ginos1998/SDC-TP_Final/DOCUMENTACION/Proyecto-Integrador-Informe-V1.1.0.docx.pdf

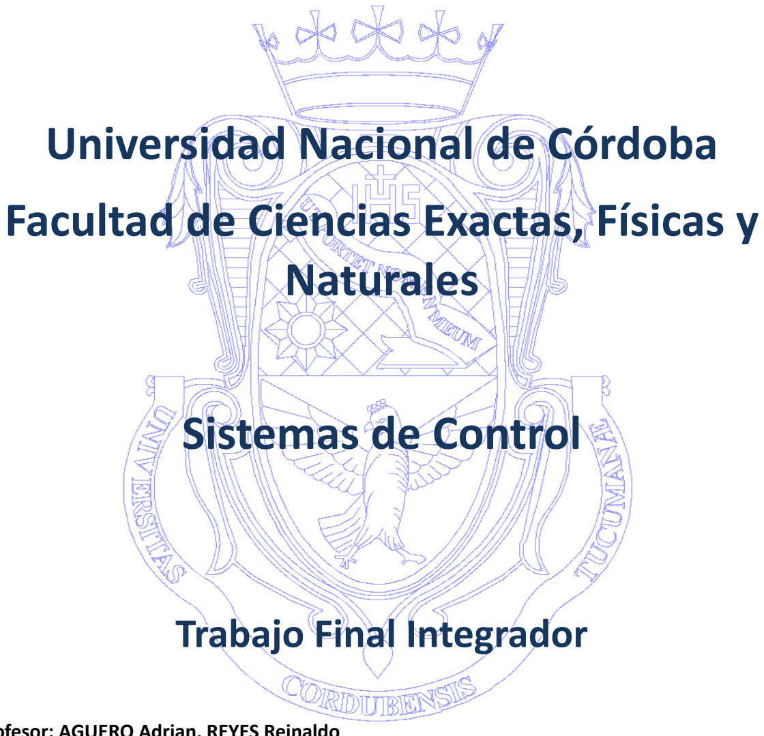
[picture p1: figure]
Universidad Nacional de Córdoba; Facultad de Ciencias Exactas, Físicas y Naturales; Sistemas de Control; Trabajo Final Integrador

Profesor: AGUERO Adrian, REYES Reinaldo

Alumno/s: SIAMPICHETTI Gino, MAFFINI Agustin

Matrícula/s: 41411540,

Carrera: Ing Computación

UNC- FCEFyN | Sistemas de Control

# Índice

Introducción | 2
Análisis sin considerar la carga | 3
Determinación de los elementos a utilizar | 3
Modelado del motor de corriente continua | 3
Diagrama de bloques del sistema | 5
Determinación de la función de transferencia del sistema | 5
Estimación 1 | 6
Estimación 2 | 8
Análisis del error de régimen permanente | 10
Respuesta transitoria | 11
Análisis de Estabilidad | 12
Lugar de Raíces | 13
Análisis considerando la carga | 14
Diagrama de bloques del sistema completo | 14
Determinación de la función de transferencia del sistema completo | 15
Compensación | 16
Ajuste del Compensador | 19
Respuesta del sistema compensado para una entrada escalón | 22
Lugar de Raíces | 23
Análisis del error de régimen permanente | 24
Análisis de estabilidad de Routh-Hurwitz | 24
Diagrama de Bode del sistem | 25
Esquema del circuito físico | 25
Conclusión | 26
ANEXO | 27
Obtención de datos para calcular la función de transferencia de la planta | 27
Implementación de PID en Arduino | 28
Filtro de Media Móvil Exponencial | 28

## Introducción

Con el fin de aplicar los conocimientos adquiridos en la asignatura Sistemas de Control I, desarrollamos este trabajo práctico integrador basándonos en el control de levitación de una pelota de telgopor, la cual se desplaza verticalmente dentro de un tubo cilíndrico transparente, impulsada por un soplador de aire (motor CD con paletas planas perpendiculares al sentido de giro). La posición de la pelota es ajustada con la posición de la mano, detectada por un sensor ultrasónico, con un rango de 0-39 cm.

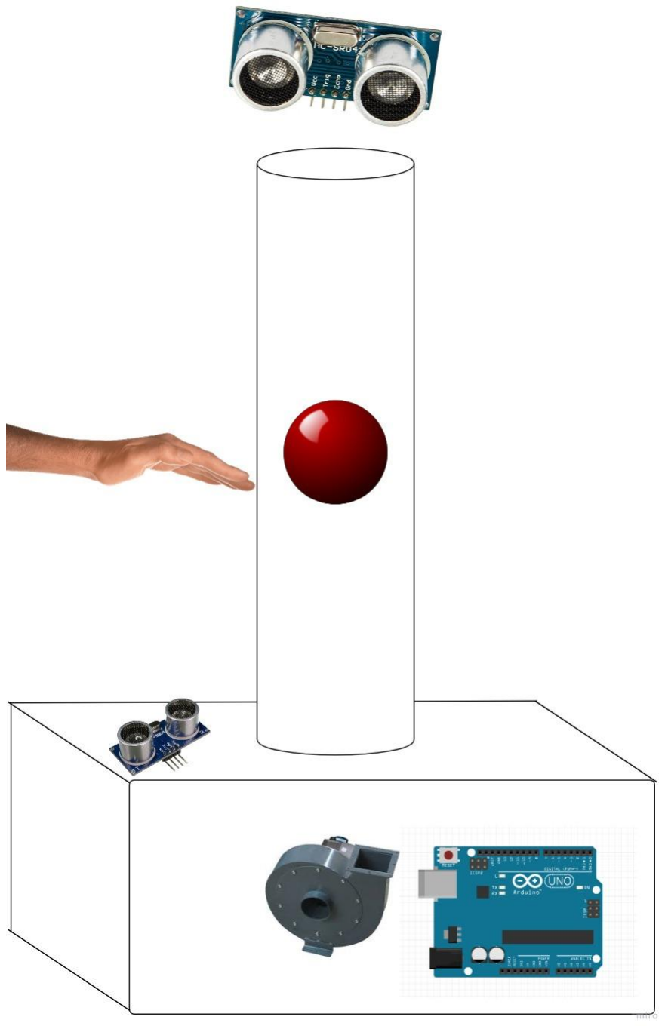
[picture p2: figure]

## Desarrollo

## Análisis sin considerar la carga

### Determinación de los elementos a utilizar

- Arduino UNO
- Motor DC (Datasheet) (https://github.com/ginos1998/SDC-TP_Final/blob/master/DOCUMENTACION/RF-370CA-153.pdf)
- (2) Sensor ultrasonico HC-SR04 (Datasheet) (https://github.com/ginos1998/SDC-TP_Final/blob/master/DOCUMENTACION/Datasheet-HC-SR04.pdf)
- Resistencia 220 [Ω]
- Transistor NPN 2N2222A
- Diodo 1N4007
- Esfera telgopor (pelota)
- Protoboard
- Entre otros

### Modelado del motor de corriente continua

El motor DC controlado por inducido utiliza la corriente del inducido como la variable de control. El campo en el estator se puede establecer mediante una bobina de excitación y corriente o un imán permanente. En la siguiente figura se muestran los elementos más importantes:

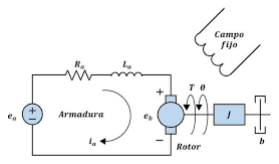
[picture p3: figure]

Podemos analizar este circuito en el dominio del tiempo, planteando las siguientes ecuaciones

e
a

(t) = R
a

i
a

(t) + L
a

di
a

(t)
dt + e
b

(t)

e
a

(t) − R
a

i
a

(t) − e
b

(t) = L
a

di
a

(t)
dt

(1)

donde e es la fuerza contraelectromotriz.
b

(t)

Observando la parte mecánica,

T
m

(t) = J

dω(t)
dt + Bω(t)

T
m

(t) − Bω(t) = J

dω(t)
dt

(2)

Donde T | es el torque del motor de corriente continua, es el coeficiente de fricción equivalente al m
(t) | B
motor de CD (corriente continua) y la carga montados sobre el eje del motor, J es el momento de inercia total del rotor y de la carga con relación al eje del motor, ω(t) es la velocidad angular del motor y

dω(t)
dt
es la aceleración angular.

Asumiendo que existe una relación proporcional K (constante contraelectromotriz ) entre el voltaje
a

V
rad s
inducido en la armadura y la velocidad angular del eje del motor,

e
b

(t) = Kaω(t) (3)

Y se supone la siguiente relación electromecánica que establece que el torque mecánico es proporcional, K (Constante de Torque [Nm / A]), a la corriente eléctrica que circula por el motor DC. m

T
m

(t) = Km

i
a

(t) (4)

Podemos aplicar la transformada de Laplace a las ecuaciones 1, 2, 3 y 4 para obtener con mayor facilidad la función de transferencia

E
a

(s) − R
a

I
a

(s) − E
b

(s) = sL
a

I
a

(s) (5)

T
m

(s) − Bω(s) = Jsω(s) (6)

E
b

(s) = Kaω(s) (7)

T
m

(s) = Km

I
a

(s) (8)

Queremos obtener la relación velocidad angular con el voltaje de entrada, ω(s)/E .
a

(s)

De la ecuación 8, podemos despejar la corriente

I
a

(s) =

T
m

(s)
Km

(9)

de la ecuación 6, despejamos el torque del motor

T
m

(s) = ω(s)(Js + B) (10)

reemplazamos la ecuación 10 en la 9

I | )
a

(s) =

ω(s)(Js+B)
Km

(11

reemplazamos la ecuación 7 en la 5 y agrupamos los términos en función de la corriente

E
a

(s) − Kaω(s) = I
a

(s)(sL

a + R
a

) (12)

reemplazamos la ecuación 11 en la 12 y agrupamos los términos en función de la velocidad angular

E
a

(s) − Kaω(s) =

ω(s)(Js+B)
Km

(sL

a + R
a

)

E
a

(s) = ω(s)[

(Js+B)(sL

a+R
a

)
Km

+ Ka

]

E
a

(s) = ω(s)[

(Js+B)(sL

a+R
a

)+Ka

Km
Km

]

por último, despejamos y desarrollamos para obtener la relación entre el voltaje de entrada y la velocidad (salida):

ω(s)
E
a

(s) =

Km
(Js+B)(sL

a+R
a

)+Ka

Km

ω(s)
E
a

(s) =

Km

JL
a

s

2+(JR
a+BL
a

)s+Ka

Km

### Diagrama de bloques del sistema

Respecto al modelado matemático, el diagrama de bloques en el dominio de Laplace es

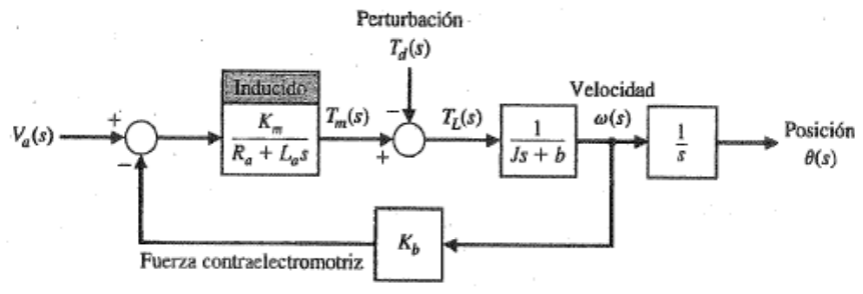
[picture p4: figure]

Si bien el motor CD es de lazo abierto, la realimentación negativa de ganancia K se ilustra solo para el
b
modelo matemático.

### Determinación de la función de transferencia del sistema

Para determinar la función de transferencia a lazo abierto del motor de corriente continua utilizado, al desconocer sus características físicas, optamos por realizar mediciones experimentales con ayuda del Arduino UNO, un módulo de sensor infrarrojo y en el eje del motor colocamos una hélice liviana de 8 palas. De esta manera, al girar la hélice, el sensor infrarrojo detecta las palas y el Arduino cuenta la cantidad en un tiempo de muestreo determinado, mediante interrupciones. El resultado es RAD/s ante la entrada escalón unitario sobre el motor CD. Ver código implementado en Arduino. (https://github.com/ginos1998/SDC-TP_Final/blob/master/ARDUINO/measure-rpm/measure-rpm.ino)

A continuación, se detalla el procedimiento introducido en Matlab para obtener la función de transferencia a partir de los resultados obtenidos. (https://docs.google.com/spreadsheets/d/1CccnxNx0YsGrc_fS6bcSLwauPOYd9gacbLGMbrZcVQQ/edit?usp=sharing)

Estimación 1

Se definieron los vectores u y rads (entrada escalón y velocidad angular, respectivamente). La herramienta 'iddata()' nos permite encapsular los valores medidos de entrada y salida para el sistema (motor) que queremos identificar, con un tiempo de muestreo dado. (Datos: hoja 1) (https://docs.google.com/spreadsheets/d/1CccnxNx0YsGrc_fS6bcSLwauPOYd9gacbLGMbrZcVQQ/edit#gid=0)

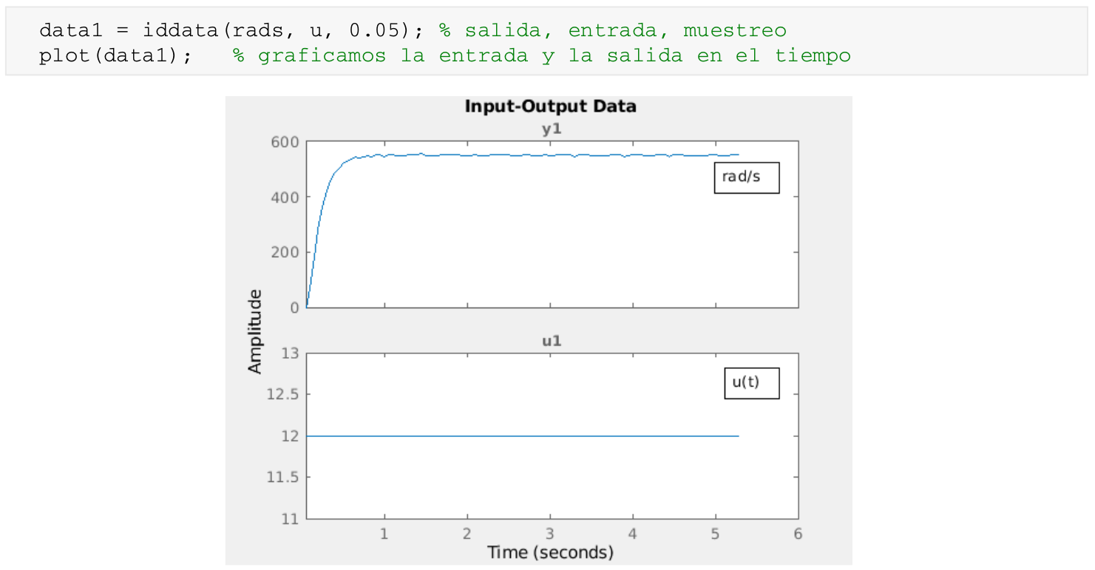
[picture p5: figure]

Con la herramienta 'tfest()' realizamos una estimación de la función de transferencia, según los polos y ceros que indiquemos. En principio, el sistema parece ser de primer orden:

obteniendo una estimación muy buena del 90.9%. Sin embargo, del modelado matemático sabemos que la función de transferencia de un motor CD es de segundo orden, con 2 polos y ningún zero:

En este caso, la estimación aumentó a 97.65% y la función de transferencia calculada es

TF
20

(s) =

8104
s

2+31.83s+176.6

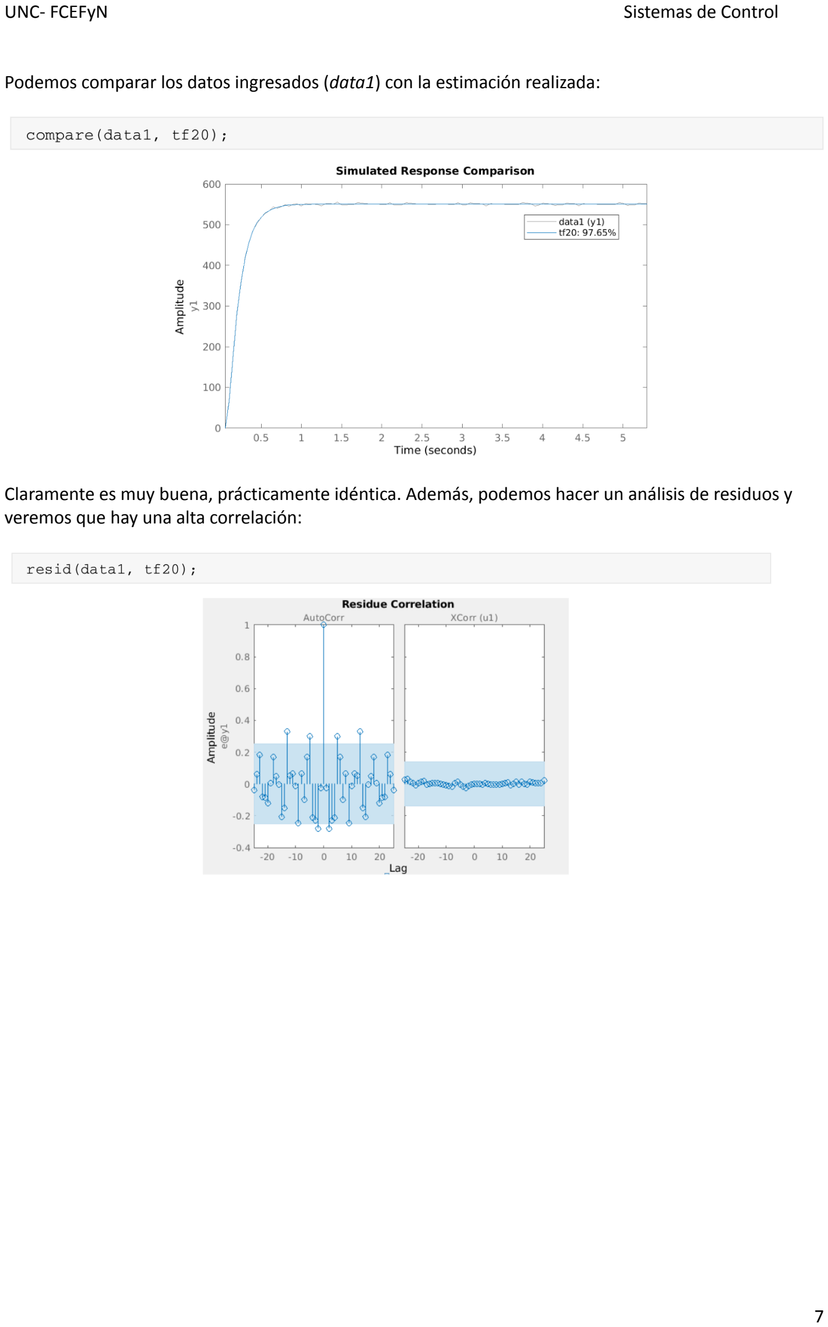
[picture p6: page 8]

Podemos comparar los datos ingresados (data1) con la estimación realizada:

Claramente es muy buena, prácticamente idéntica. Además, podemos hacer un análisis de residuos y veremos que hay una alta correlación:

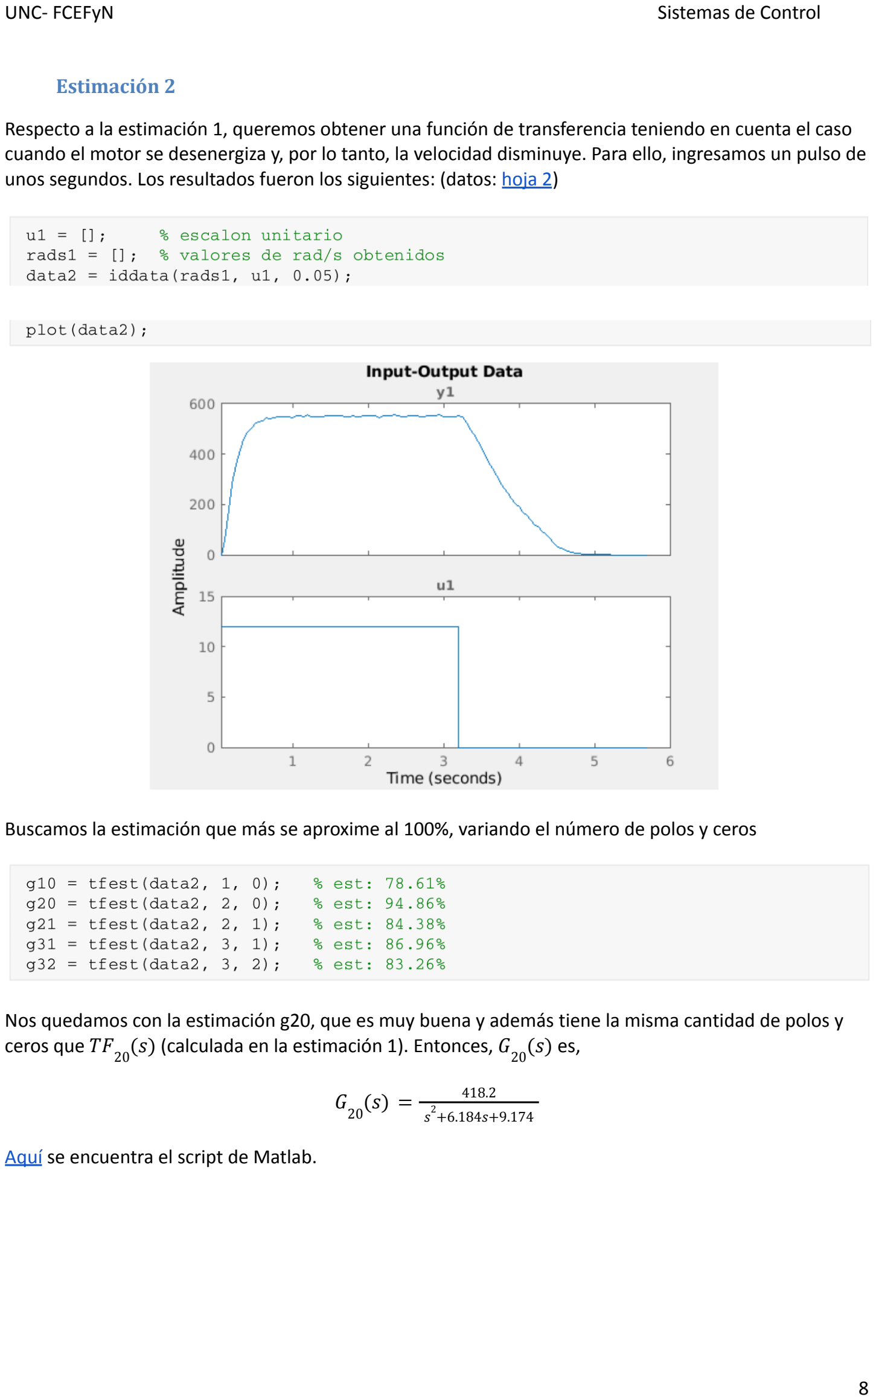
[picture p7: page 9]

Estimación 2

Respecto a la estimación 1, queremos obtener una función de transferencia teniendo en cuenta el caso cuando el motor se desenergiza y, por lo tanto, la velocidad disminuye. Para ello, ingresamos un pulso de unos segundos. Los resultados fueron los siguientes: (datos: hoja 2) (https://docs.google.com/spreadsheets/d/1CccnxNx0YsGrc_fS6bcSLwauPOYd9gacbLGMbrZcVQQ/edit)

Buscamos la estimación que más se aproxime al 100%, variando el número de polos y ceros

Nos quedamos con la estimación g20, que es muy buena y además tiene la misma cantidad de polos y
ceros que TF | (calculada en la estimación 1). Entonces, | es,
20
(s) | G
20

(s)

| G
| 20 (s) =
| 418.2 s 2+6.184s+9.174

Aquí (https://github.com/ginos1998/SDC-TP_Final/blob/master/SCRIPTS-MATLAB/estimaciones_tf.mlx) se encuentra el script de Matlab.

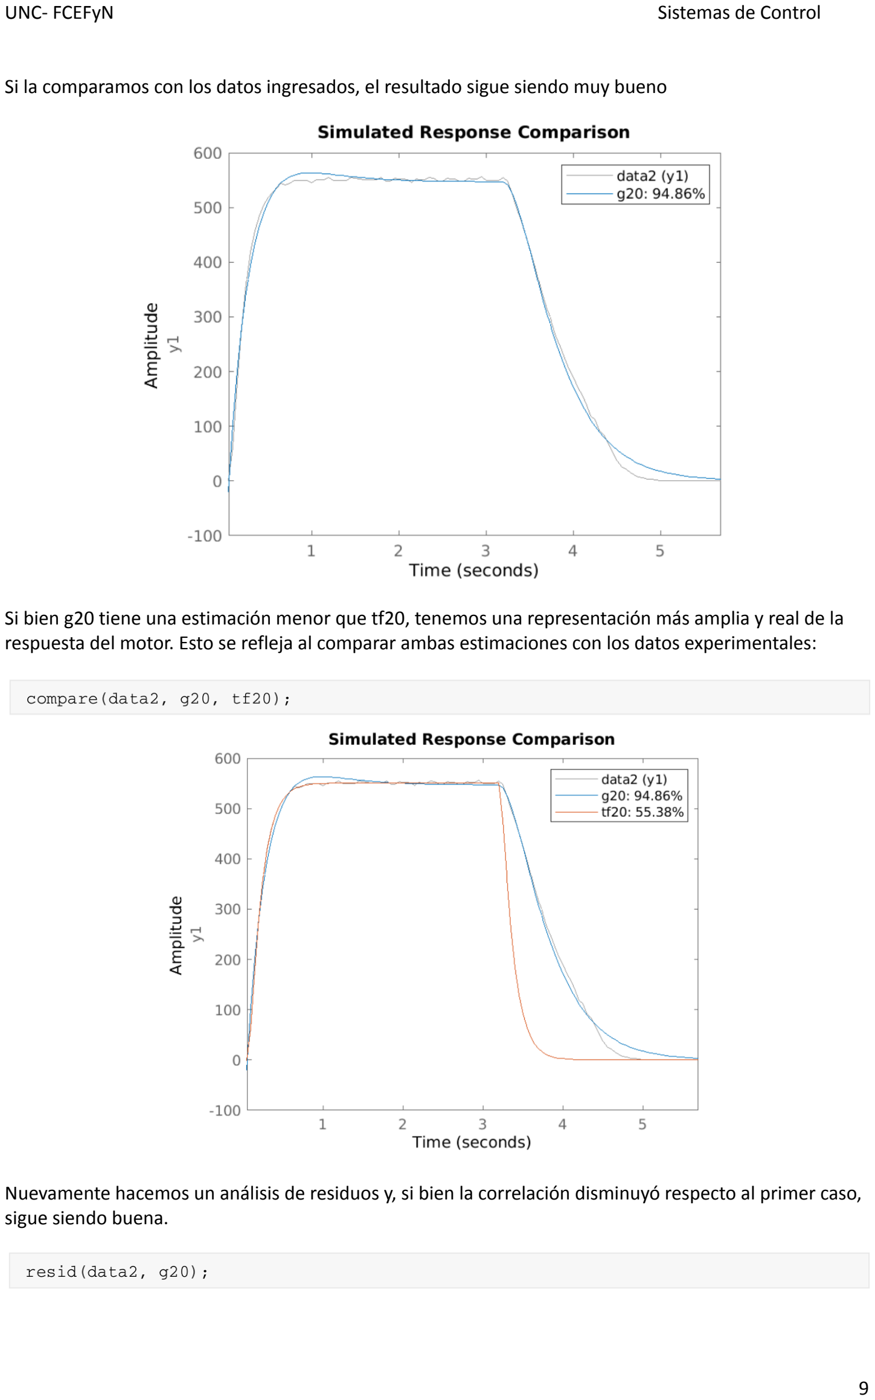
[picture p8: page 10]

Si la comparamos con los datos ingresados, el resultado sigue siendo muy bueno

Si bien g20 tiene una estimación menor que tf20, tenemos una representación más amplia y real de la respuesta del motor. Esto se refleja al comparar ambas estimaciones con los datos experimentales:

Nuevamente hacemos un análisis de residuos y, si bien la correlación disminuyó respecto al primer caso, sigue siendo buena.

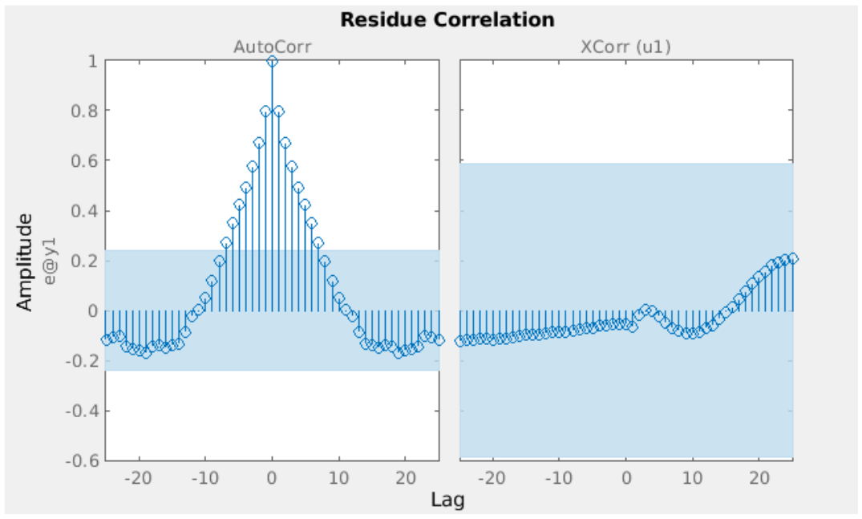
[picture p9: figure]

De esta manera, concluimos que la función de transferencia a lazo abierto del motor CD es G :
20

(s)

G
20

(s) =

418.2
s

2+6.184s+9.174

Comparando esta expresión con una típica de segundo orden,

F(s) =

Km

s

2+2ζωn
s+ωn

2

Km = 418. 2 ; 2ζωn = 6. 184 ; ωn

2 = 9. 174 → ωn = 3. 023 ; ζ = 1. 021

Con este resultado realizaremos los siguientes análisis y diseños.

### Análisis del error de régimen permanente

Observando la expresión G , vemos que es un sistema de tipo 0, por lo tanto
20
| (s)
- Entrada escalón u(t):

k

p =
s→0

lim G
20

(s) =

418.2
0+0+9.174 = 45. 585 | → | ess =

1
1+kp = 0. 021
- Entrada rampa r(t)

k

v =
s→0

lim sG
20

(s) = 0

418.2
0+0+9.174 = 0 | → | ess =

1
kv = ∞
- Entrada parábola p(t):

k

a =
s→0

lim s

2G
20

(s) = 0

2 | 418.2
0+0+9.174 = 0 | → | ess =

1
ka = ∞

### Respuesta transitoria

Tenemos una función de transferencia de segundo orden, por lo tanto analizamos los parámetros ω y :
n

ζ

ωn = 3. 023 ; ζ = 1. 021

- ζ ≈ 1, entonces decimos que es un sistema de amortiguamiento crítico.

Para analizar más detalladamente su respuesta temporal, graficamos la respuesta al escalón de la función de transferencia G del motor:
20

(s)

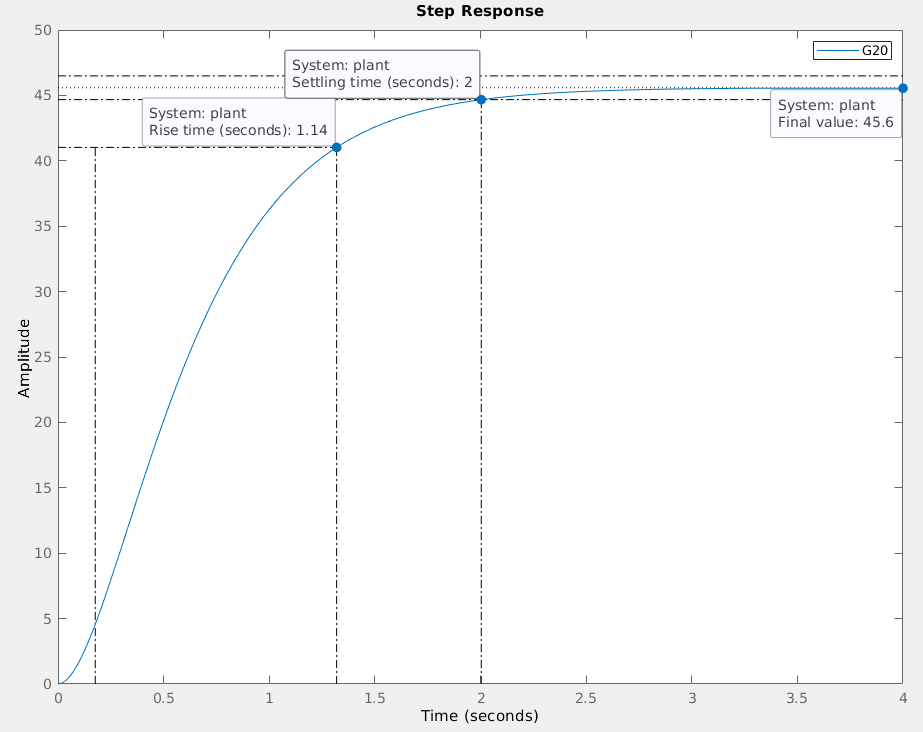
[picture p10: figure]

Del gráfico observamos que el tiempo que tarda el sistema en ir desde una amplitud del 10% al 90% es de 1.14 segundos (rise time), el tiempo que tarda en establecerse es de 2 segundos (settling time, tolerancia 5%) y el valor final es de 45.6 (final value). El sistema no presenta sobrepasamiento, por lo cual, no tenemos un tiempo pico.

### Análisis de Estabilidad

Para analizar si el sistema es estable, utilizaremos el método de Routh. El criterio se refiere a la función de transferencia en lazo cerrado del sistema con realimentación unitaria, por lo cual desarrollamos el polinomio en el denominador de G , es decir,
20
| (s)

G
CL
| (s) = G
| 20 (s) 1+G
| 20 (s) =

418.2
s

2+6.184 s+427.37

la ecuación característica se encuentra en el denominador

| p(s) = s
| 2 + 6. 184s + 427. 37

Analizamos si en la primera columna de la siguiente tabla hay cambio de signo

| a 0 | a 2
2 s | 1.0 | 427. 37
| a 1 | a 3
1 s | 6.184 | 0
| b 0 | b 1
0 s | 427. 37 | 0

como no lo hay, entonces decimos que el sistema es estable.

Además, podemos determinar si el sistema es estable a partir de los polos de
G | . Ambos polos se encuentran a la izquierda del eje imaginario en
20

(s): p

1 =− 3. 71 , p

2 =− 2. 47
el plano S. Por lo tanto, concluimos que efectivamente es sistema es estable.

### Lugar de Raíces

Analizamos la función de transferencia G para graficar el lugar de raíces (LdR). En principio,
20

(s)
sabemos que tiene 2 polos, por lo cual el LdR tiene 2 ramas que comienzan en dichos polos y terminan en ± ∞, ambas con un ángulo de salida de 90°. El centroide se ubica en

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
m−n =

−3.71−2.47−0
2−0 =− 3. 09

donde m y n son la cantidad de polos y ceros, respectivamente. Graficamos el LdR en Matlab:

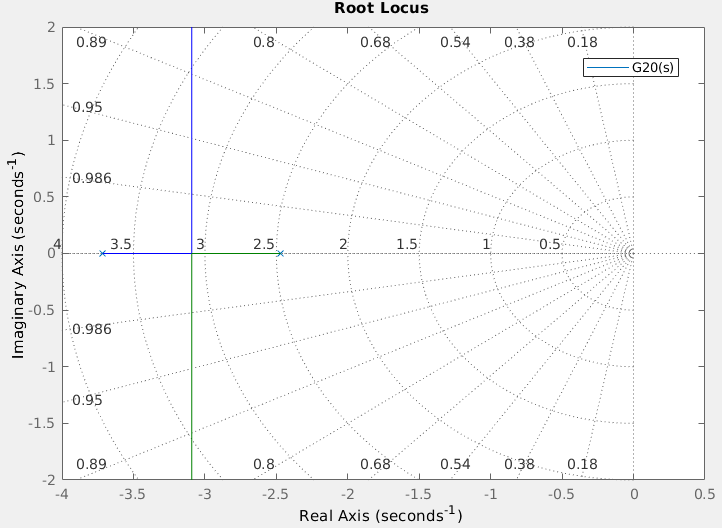
[picture p11: figure]

## Análisis considerando la carga

### Diagrama de bloques del sistema completo

El diagrama de bloques del sistema en general se muestra a continuación. La entrada es el sensor de la mano, que ingresa una referencia en centímetros. El sumador hace la diferencia entre la entrada y la realimentación (unitaria, en este caso). Luego se encuentra el controlador para la planta. La salida es la posición de la pelota, en centímetros.

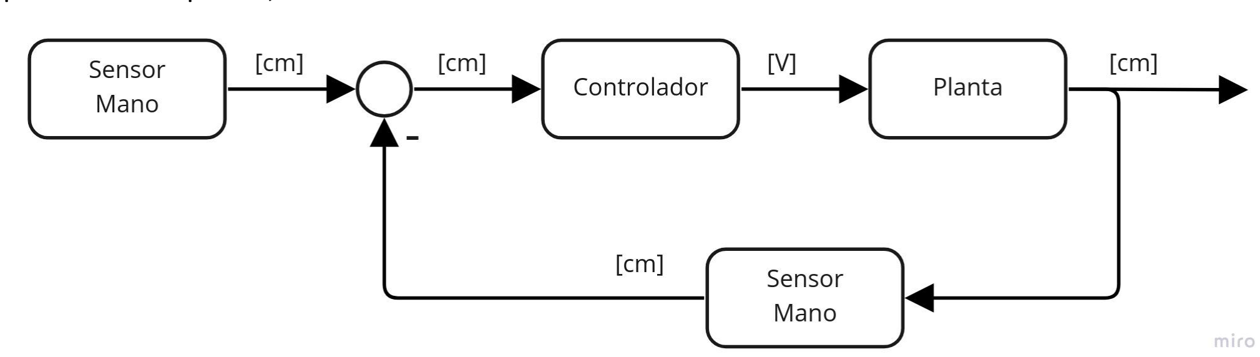
[picture p12: figure]

En principio, el controlador es un PID (Proporcional-Integrador-Derivador).

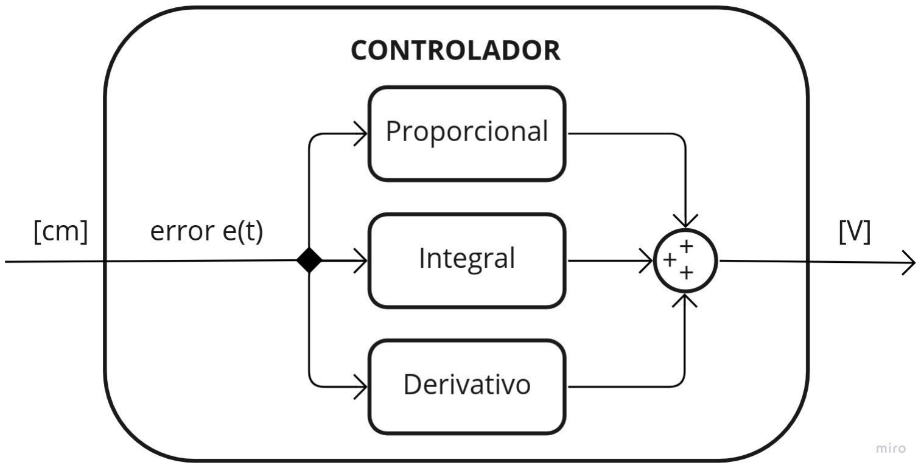
[picture p13: figure]

La planta se compone de un amplificador para controlar el motor DC, el cual eleva la pelota en el tubo.

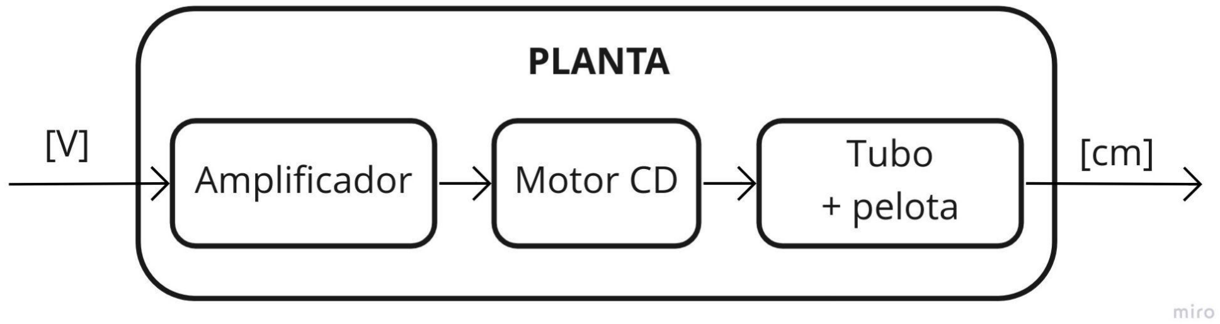
[picture p14: figure]
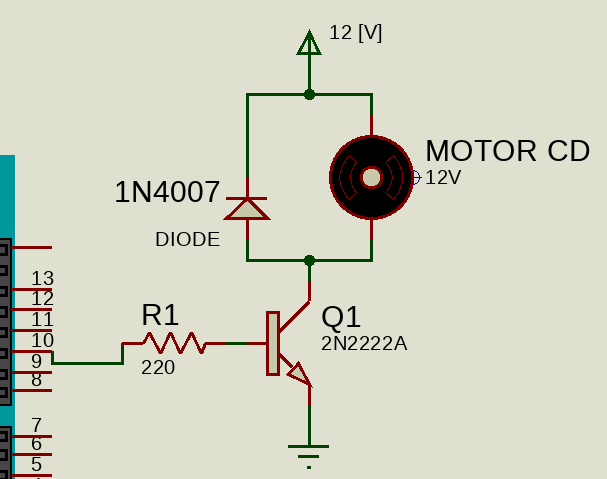
[picture p15: figure]

### Determinación de la función de transferencia del sistema completo

Para obtener la función de transferencia del sistema completo, realizamos un procedimiento similar al presentado previamente. Es decir, aplicamos una entrada escalón a la planta y la salida será la altura a la que se eleva la pelota, obtenida con un tiempo de muestreo. Ver Anexo para más detalles.

Los datos de entrada-salida se encuentran aquí.

Nuevamente, con la ayuda de Matlab, realizamos la estimación de la función de transferencia. Para los datos ingresados:

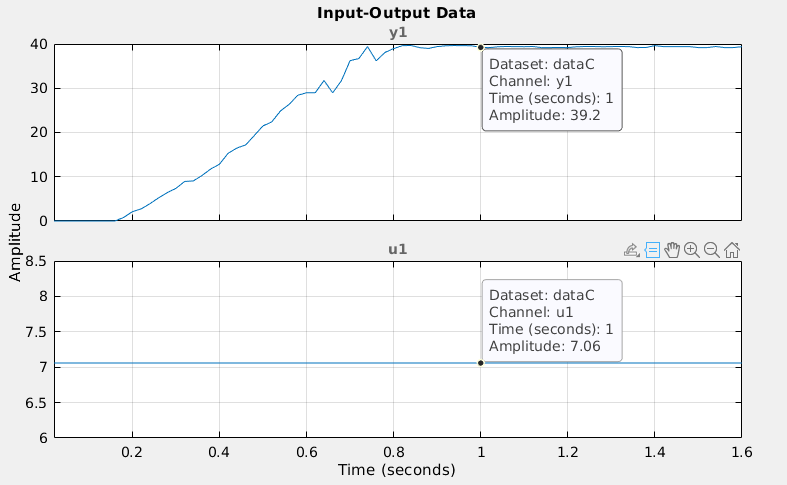
[picture p16: figure]

estimamos una función de transferencia con 0 ceros y 2 polos, y el resultado se ajusta a una estimación del 92.28%.

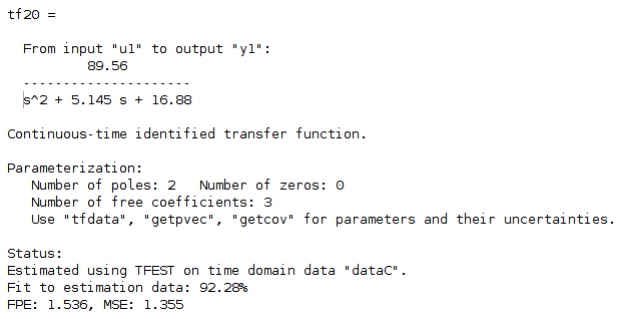
[picture p17: figure]

De esta manera, la función de transferencia de la planta con carga y a lazo abierto es

G
POL

(s) =

89.56
s

2+5.145s+16.88

En la siguiente figura podemos ver la correlación entre los datos ingresados y la respuesta de G a
POL

(s)
la misma entrada escalón.

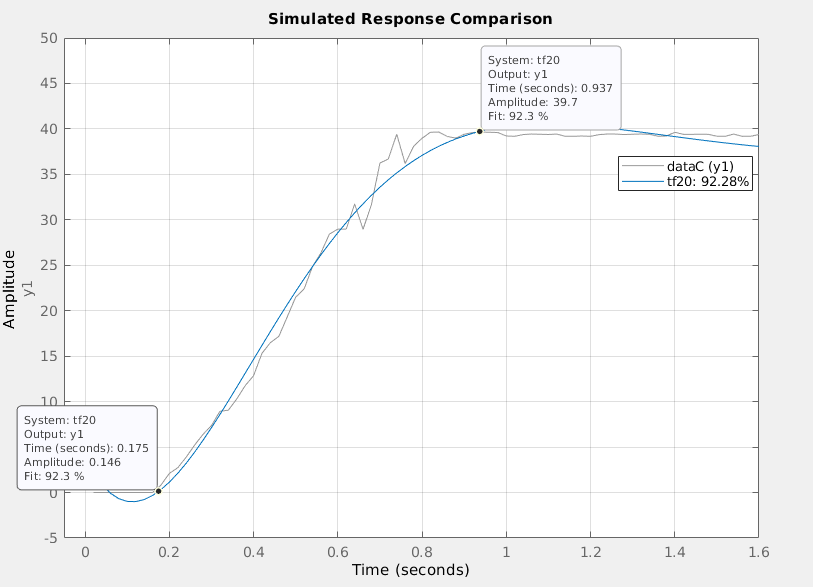
[picture p18: figure]

### Compensación

Para el diseño del compensador, primero planteamos que los objetivos son: una respuesta rápida del
sistema (t | ) con leve amortiguamiento, error en estado estable nulo ( | ) para entrada
S = 3 [s] | ess = 0
escalón y sobrepasamiento OS = 5%. Un compensador PID (proporcional-integrador-derivativo) podría satisfacer estas necesidades.

Un compensador PID tiene la forma

G
PID

(s) = K

P +

Ki
s + K
D

s =

KD

s

2+KP
s+Ki
s
donde K | son las constantes proporcional, integral y derivativa, respectivamente.
P

, K
i

y K
D

Si hacemos el producto del compensador con la planta,

G
OL

(s) = G
PID

(s) G
POL

(s) =

89.56 (KD

s

2+KP
s+Ki

)

s(s

2+5.145 s+16.88)

podemos notar que G | es un sistema es de tipo 1, por lo tanto se cumple | para una entrada
OL
(s) | ess = 0
escalón.

Dados los requerimientos de diseño, calculamos el polo de trabajo P
T

ζ =

ln²(Mp)
ln²(Mp)+π

2 =

ln²(0.05)
ln²(0.05)+π

2 = 0. 6901

ωn =

5
t
s

ζ =

5
3x0.69 = 2. 4151

P

T =− ζωn ± ωn

1 − ζ

2 =− 1. 6667 ± j1. 7478

Graficamos el lugar de raíces de G a lazo abierto con la herramienta ‘controlSystemDesigner’ de
POL

(s)
Matlab.

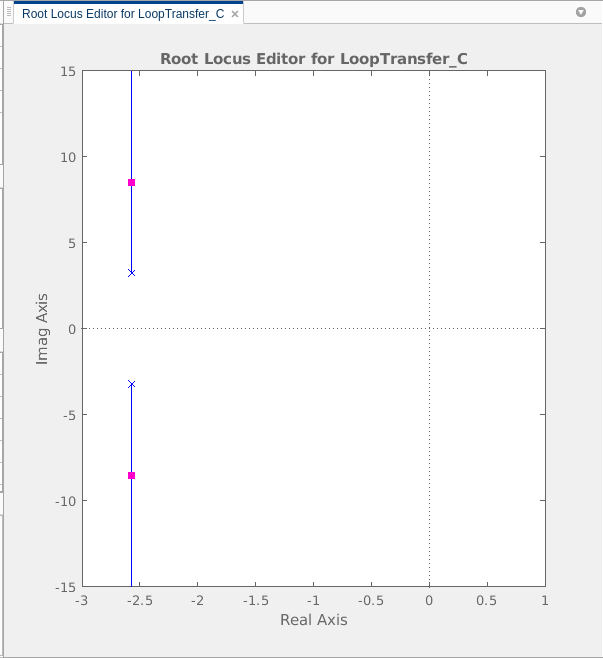
[picture p19: figure]
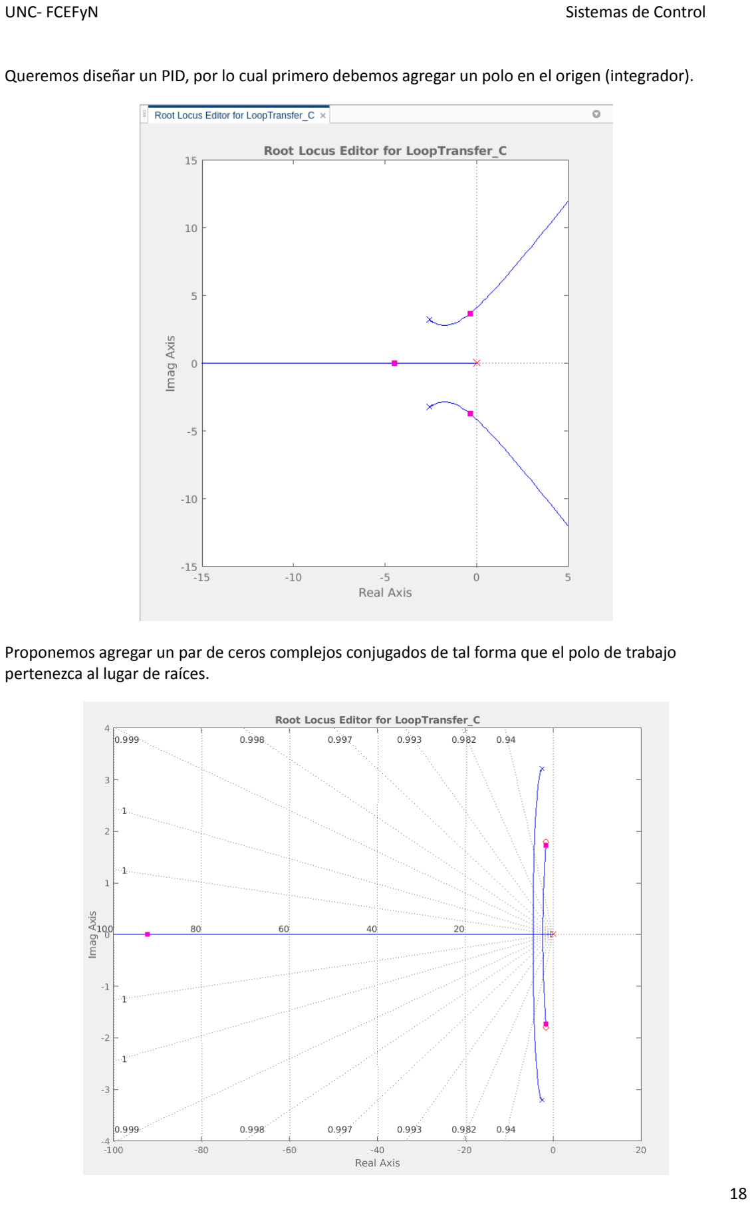
[picture p20: page 19]

Queremos diseñar un PID, por lo cual primero debemos agregar un polo en el origen (integrador).

Proponemos agregar un par de ceros complejos conjugados de tal forma que el polo de trabajo pertenezca al lugar de raíces.

Colocando los ceros en − 1. 64 ± j1. 79 logramos que el polo de trabajo pertenezca al lugar de raíces y ajustamos la ganancia tal que se cumplan los requerimientos. A esto último lo podemos verificar con la herramienta que estamos utilizando, agregando nuestras especificaciones en el mismo plano S.

El compensador que obtuvimos es

G
PID

(s) =

5.9676+3.3481 s+1.003 s

2
s

las constantes del compensador quedan a la vista

G
PID

(s) =

5.9676+3.3481 s+1.003 s

2
s | =

KD

s

2+KP
s+Ki
s

K

P = 3. 3481 ; K

i = 5. 9676 ; K

D = 1. 003

Aquí (https://github.com/ginos1998/SDC-TP_Final/blob/master/SCRIPTS-MATLAB/est-tf-plant.m) se puede encontrar el script en Matlab.

### Ajuste del Compensador

Hasta aquí, hemos desarrollado la función de transferencia de la planta y compensador en base a estimaciones que, si bien obtuvimos buenas aproximaciones, es aceptable que en la práctica haya que ajustar algunos detalles. Es por ello que queremos observar cómo responde el sistema a lazo cerrado con el compensador diseñado. Para ello, desarrollamos un código en Arduino. Ver Anexo para más detalles.

En principio, queremos posicionar la pelota a una altura de 20 cm. Luego con la mano le damos otros puntos de referencia. Observamos que la pelota alcanza rápidamente la altura de referencia, pero oscila mucho y nunca se estabiliza en un punto concreto.

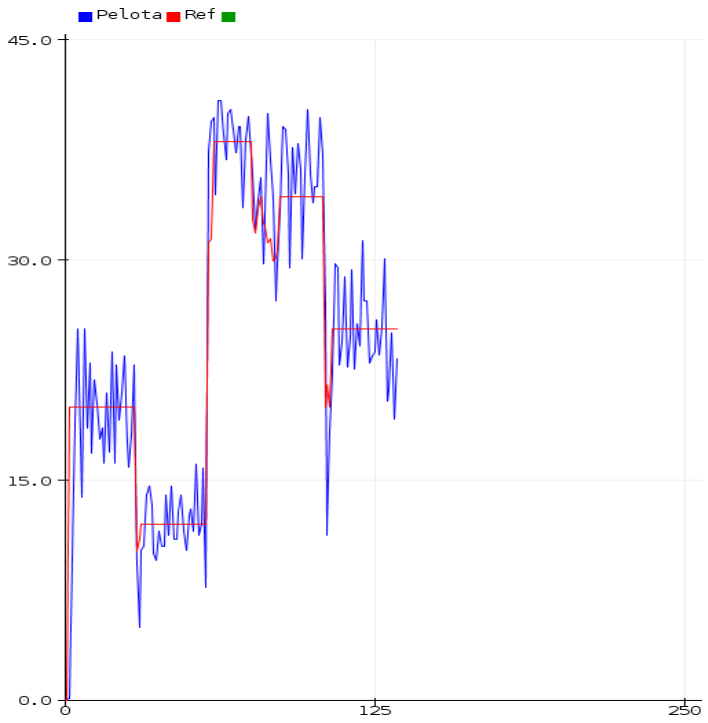
[picture p21: figure]

Probamos que disminuir la constante derivativa e integrativa, ambas un 10%

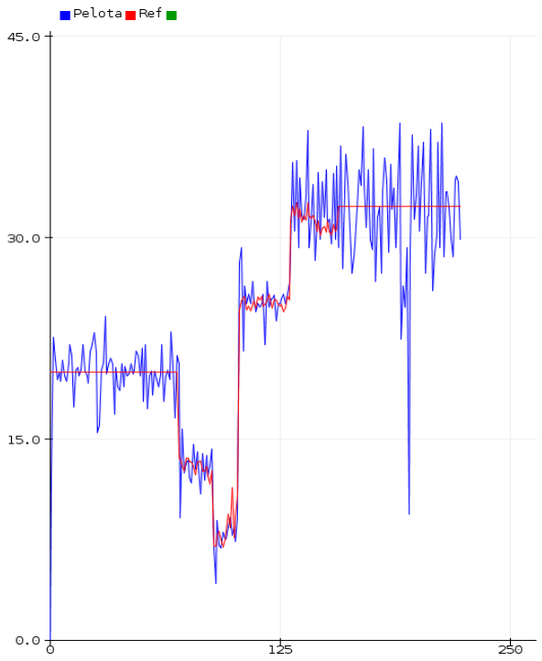
[picture p22: figure]

Para una referencia menor a 30 cm, vemos que el tiempo de establecimiento es rápido y la posición de la pelota es relativamente estable, pero una referencia mayor, es decir una altura más elevada, presenta oscilaciones. Esto nos llevó a la conclusión de que la planta no es un sistema lineal, y esto se puede corroborar con el gráfico ‘Input-Output Data’. Entonces, debemos linealizarlo de alguna manera para implementar el controlador PID. La solución que encontramos para minimizar el error es dividir el tubo en 4 partes distintas, como se muestra en la siguiente figura:

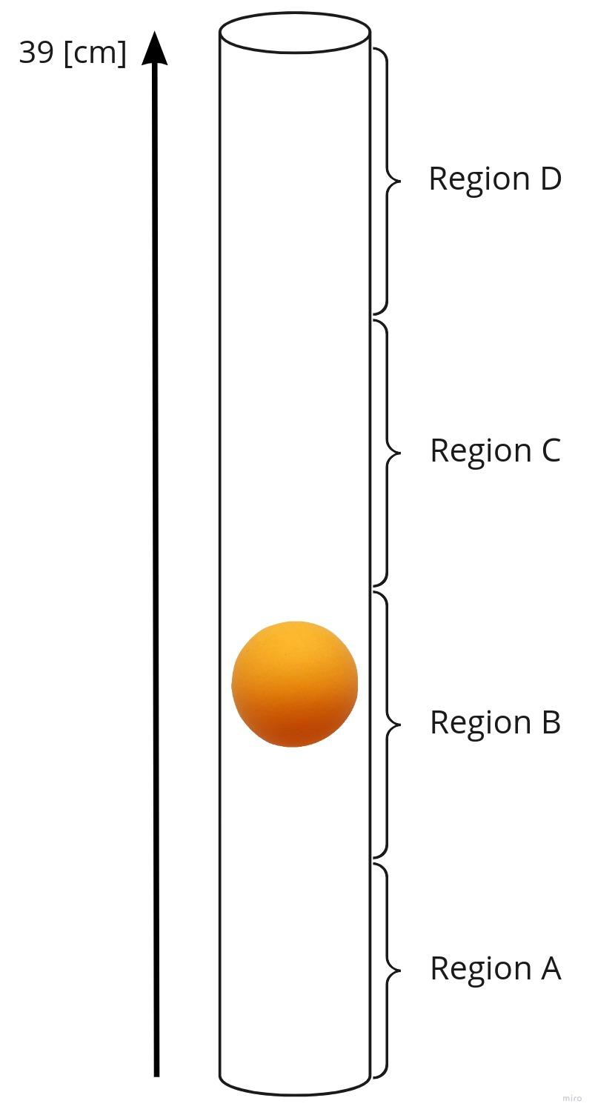
[picture p23: figure]

Tenemos las regiones A={0, 9}, B={9.1, 18}, C={18.1, 30} y D={30.1, 40} por lo tanto las constantes para el PID serán distintas. De esta manera, tendremos las constantes:

regionA = {Kpa, Kia, Kda}, regionB = {Kpb, Kib, Kdb}, regionC = {Kpc, Kic, Kdc}, regionD = {Kpd, Kid, Kdd}

que se determinan de manera experimental. Es intuitivo pensar que en la región A necesitamos una constante proporcional más grande, porque el flujo de aire es más turbulento y se requiere más fuerza para elevar la pelota desde el reposo.

Por otro lado, en la parte superior tenemos que el aire fluye más estable y el movimiento de la pelota es sensible a los cambios en la energía del motor.

Proponemos

regionA = {4.3325, 4.8, 0.1}, regionB = {3.4821, 5.6, 0.2},

regionC = {3.3481, 5.2, 0.4}, regionD = {1.25, 1, 0.01}

y los resultados fueron aceptables, teniendo en cuenta las imprecisiones de los sensores ultrasónicos. Para reducir estos errores, implementamos un filtro pasabajos denominado ‘filtro media móvil exponencial’. De todas formas, el compensador actúa rápido y sin oscilaciones relevantes.

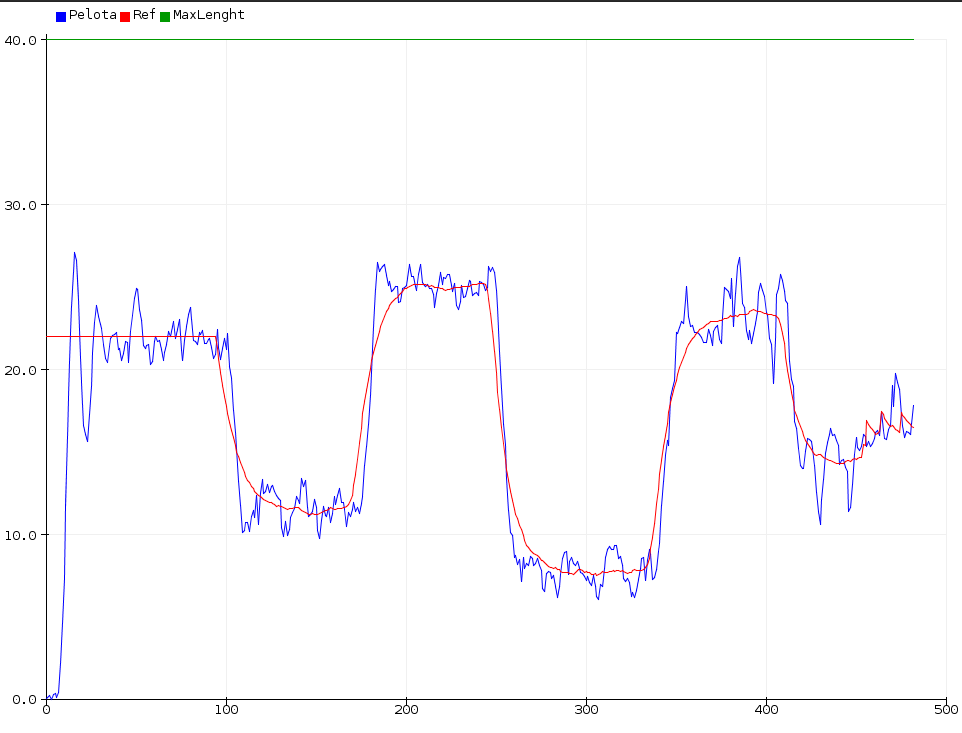
[picture p24: figure]
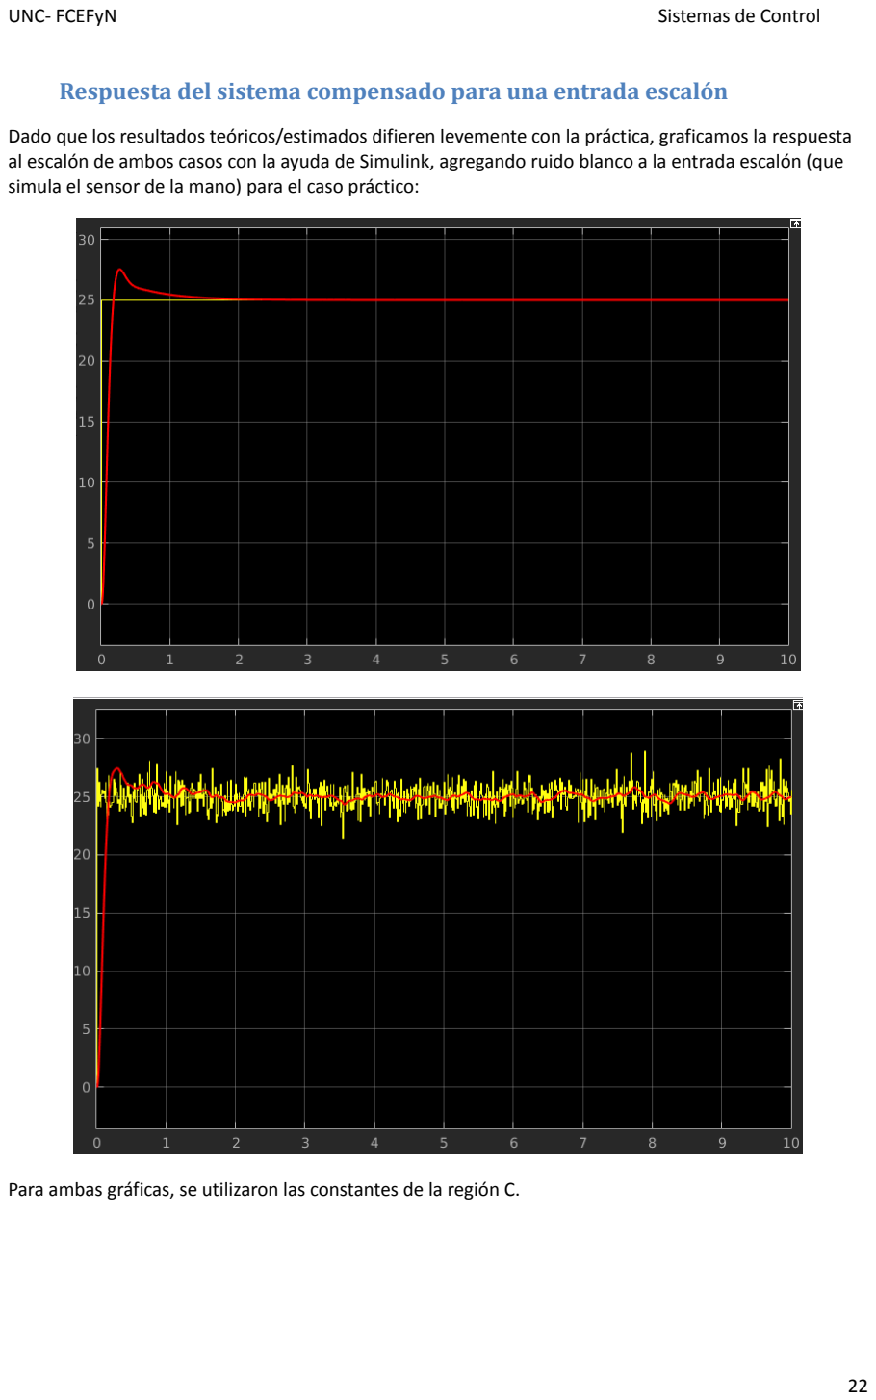
[picture p25: page 23]

### Respuesta del sistema compensado para una entrada escalón

Dado que los resultados teóricos/estimados difieren levemente con la práctica, graficamos la respuesta al escalón de ambos casos con la ayuda de Simulink, agregando ruido blanco a la entrada escalón (que simula el sensor de la mano) para el caso práctico:

Para ambas gráficas, se utilizaron las constantes de la región C.

### Lugar de Raíces

El siguiente gráfico muestra el lugar de raíces del sistema compensado G
OL

(s)

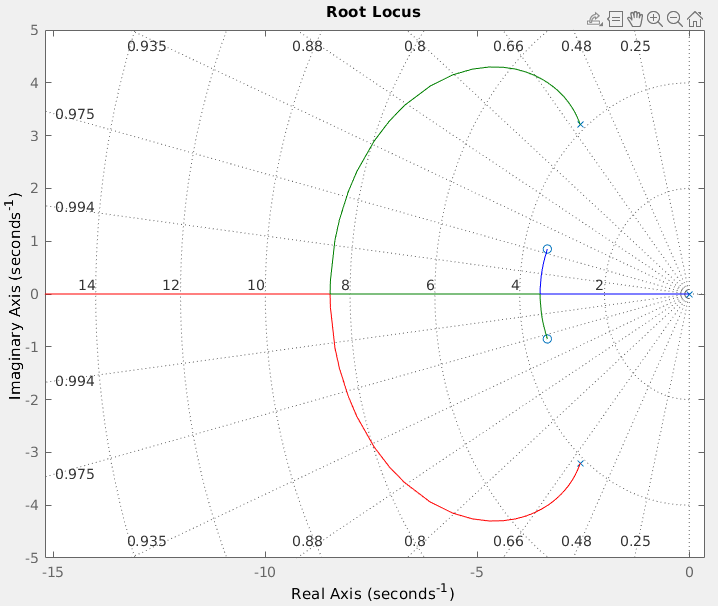
[picture p26: figure]

donde encontramos 2 polos pertenecientes a la planta, 1 polo en el origen y dos ceros complejos conjugados pertenecientes al PID.

### Análisis del error de régimen permanente

Teniendo en cuenta la FdT del sistema compensado,

G
OL

(s) =

89.56 (s

2+3.3481s+5.9676)

s(s

2+5.145 s+16.88)

vemos que se trata de un sistema de tipo 1, por lo tanto, podemos decir que

- Entrada escalón u(t):

k

p =
s→0

lim G
OL
(s) = ∞ | → | ess =

1
1+kp = 0
- Entrada rampa r(t)

k

v =
s→0

lim sG
OL

(s) =

89.56 (0

2+3.3481x0+5.9676)

(0

2+5.145x0+16.88)

= 49. 43 | → | ess =

1
49.43 = 0. 02
- Entrada parábola p(t):

k

a =
s→0

lim s

2G
OL

(s) = 0

2 89.56 (0

2+3.3481x0+5.9676)

(0

2+5.145x0+16.88)

= 0 | → | ess =

1
ka = ∞

### Análisis de estabilidad de Routh-Hurwitz

Para analizar si el sistema es estable, nuevamente utilizaremos el método de Routh

A partir del polinomio en el denominador de G , es decir,
CL

(s)

p(s) = s

3
+ 49. 92 s

2
+ 316. 7 s + 534. 5

Analizamos si en la primera columna de la siguiente tabla hay cambio de signo

a 0 | a 2
3 s | 1.0 | 3.167
| a 1 | a 3
2 s | 49.92 | 534.5
| b 0 | b 1
1 s | 305.99 | 0
| c 0 | c 1
0 s | 534.5 | 0

como no lo hay, entonces decimos que el sistema es estable.

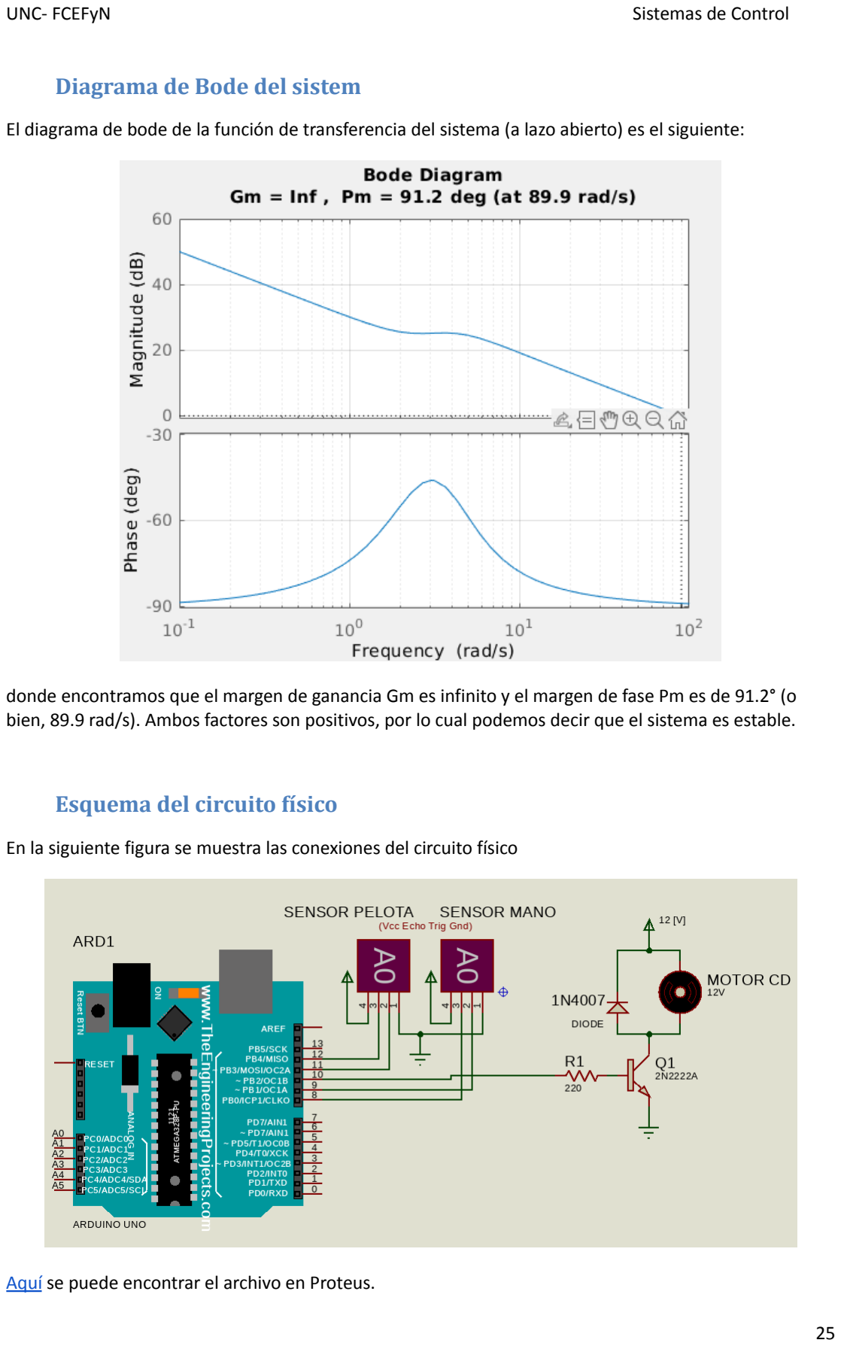
[picture p27: page 26]

### Diagrama de Bode del sistem

El diagrama de bode de la función de transferencia del sistema (a lazo abierto) es el siguiente:

donde encontramos que el margen de ganancia Gm es infinito y el margen de fase Pm es de 91.2° (o bien, 89.9 rad/s). Ambos factores son positivos, por lo cual podemos decir que el sistema es estable.

### Esquema del circuito físico

En la siguiente figura se muestra las conexiones del circuito físico

Aquí (https://github.com/ginos1998/SDC-TP_Final/tree/master/DISE%C3%91O-CIRCUITO) se puede encontrar el archivo en Proteus.

Es importante que los pines trig y el pin que controla el motor sean pines con salida PWM (~). Los sensores ultrasónicos se alimentan con 5 [V], mientras que el motor se alimenta con una fuente externa de 12 [V] / 1 [A].

## Conclusión

Pudimos diseñar y calibrar un sistema LTI con los conocimientos adquiridos en la asignatura de Sistemas de Control. Aprendimos a obtener la función de transferencia de un sistema a lazo abierto de manera experimental, ya que en este caso nos encontramos con un sistema difícil de modelar matemáticamente. Logramos cumplir con los requerimientos de diseño propuestos. Además, aprendimos cómo funcionan, cómo implementar y cómo ajustar los controladores PID, por medio de software. A pesar de los inconvenientes con el hardware (sensores ultrasónicos) logramos resultados aceptables y la pelota logra seguir la referencia ingresada (altura de la mano), con una respuesta rápida, sin sobrepasamientos importantes y leves oscilaciones. Podemos observar en la siguiente figura que inicialmente se establece una altura de referencia de 25 cm. La pelota alcanza este punto a los 0,7 segundos, con un sobrepasamiento del 5.5%. En el régimen permanente, no oscila más de un 5.6%, lo cual es aceptable. Se ve que aparentemente la pelota decae aproximadamente a los 19 cm, pero como mencionamos anteriormente, es debido al error de los sensores.

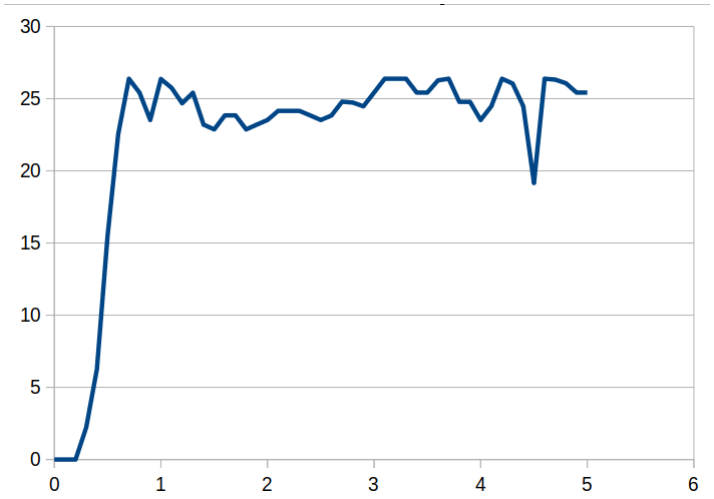
[picture p28: figure]

Es importante mencionar que linealizar el sistema fue sumamente importante para conseguir tales resultados, ya que el aire que larga el soplador y eleva la pelota no es lineal. De esta manera, el sistema es más efectivo en la región B y C. Un mejor diseño físico podría llevar a mejores resultados.

Otro factor importante fue el agregado del filtro pasabajos, que ayudó a mejorar la señal de salida en el régimen permanente, ya que sin tener presente esto, el PID lee que la pelota baja o sube mucho y se generan oscilaciones indebidas.

Lo más difícil de calibrar fue la región D porque la pelota es más sensible a los cambios del motor. Un tubo más largo y/o una pelota más pesada podría solucionar este inconveniente.

## ANEXO

### Obtención de datos para calcular la función de transferencia de la planta

Con Arduino energizamos la entrada con un escalón de 7,058 [V], equivalente a un PWM de 150. Esto se determinó en base a observaciones hechas sobre el armado físico, ya que con esa señal el tiempo en que la pelota tarda en subir desde el reposo hasta la altura máxima es considerablemente aceptable. Una señal PWM más grande hará que la pelota llegue más rápido a la altura máxima, pero luego presentará problemas para el diseño del compensador, ya que se presentan más oscilaciones.

Los pasos fueron los siguientes (Ver código en Arduino): (https://github.com/ginos1998/SDC-TP_Final/blob/master/ARDUINO/measure-ball-dist/measure-ball-dist.ino)

1. Medir la distancia entre el sensor y la pelota cuando esta se encuentra en la altura máxima (upperGap):
a. Ingresamos una entrada escalón para posicionar la pelota en el tope del tubo. Luego, tomamos 5 mediciones de distancia y sacamos un promedio para establecer el upperGap. Hicimos esto teniendo en cuenta que el sensor presenta imprecisiones para medir distancias.
2. Medir la distancia máxima del tubo (maxHeight), o bien, la distancia que puede recorrer la pelota.
a. Medimos la distancia desde el sensor hasta la pelota en reposo, y le restamos el upperGap y le sumamos el radio de la pelota. Así, obtenemos la distancia que puede recorrer la pelota al elevarse desde el reposo hasta el tope del tubo, tomando como referencia el punto medio de la pelota.
3. Ingresar una entrada escalón, con un valor de PWM de 150 (equivalente a 7,058 V), e imprimir por puerto serial la altura de la pelota, con un tiempo de muestreo de 20 ms.

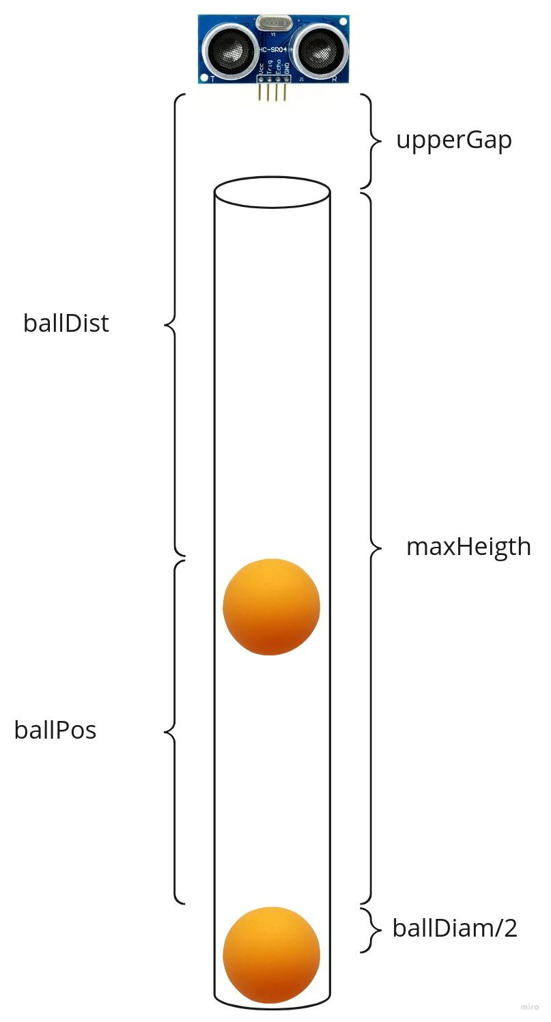
[picture p29: figure]

maxHeigℎt = ballDist − upperGap

ballPos = maxHeigℎt + upperGap − ballDist − ballDiam/2

Repetimos 4 veces el paso 3 para tomar un promedio de los datos obtenidos y así reducir los errores de medición. Luego, estos datos obtenidos por el puerto serial se copian y pegan en una hoja de cálculos para luego leer la misma desde Matlab y hacer los cálculos correspondientes de la función de transferencia.

### Implementación de PID en Arduino

Para implementar el controlador PID, utilizamos la librería <PID_v1.h> (https://playground.arduino.cc/Code/PIDLibrary/) de Arduino. Para su uso, le asignamos una variable de entrada, una de salida, la referencia y las constantes Kp, Ki y Kd. Como alternativa, podemos indicar el tiempo de muestreo. En nuestro caso, utilizamos un Ts=50 ms. Además, presenta la alternativa de cambiar las constantes mientras el sistema está en funcionamiento. Esto nos ayudó a dividir las 3 regiones con sus respectivas constantes.

Dado que hay distintas formas de implementar un PID, esta librería es de código abierto e investigamos que funciona de la siguiente manera:

PID(s) = K

P +

Ki
s + K
D

s

Aquí (https://github.com/ginos1998/SDC-TP_Final/blob/master/ARDUINO/PID_plant/PID_plant.ino) se puede encontrar el código en Arduino del proyecto completo, que incluye el PID, sensores, entre otros.

### Filtro de Media Móvil Exponencial

Un filtro de media móvil exponencial es un filtro pasabajos. La señal filtrada f(t) presenta las siguientes condiciones

f(t) = f(0) | si t = 0
f(t) = αf(t) + (1 − α)f(t − 1) | si t > 0

donde α ∈ (0, 1) es un coeficiente de suavizado, f(t) es la señal a filtrar en un tiempo actual t y f(t − 1) es la señal filtrada en un instante t − 1 anterior. Esto tiene una pequeña desventaja, pues genera un retardo en la señal filtrada respecto a la original.

En nuestro caso, ajustamos el valor de α a prueba y error, hasta llegar a un equilibrio entre las imprecisiones del sensor y el tiempo de retardo, que a grandes rasgos, no es grande.
