ginos1998/SDC-TP_Final/IMAGES/controlador.jpg

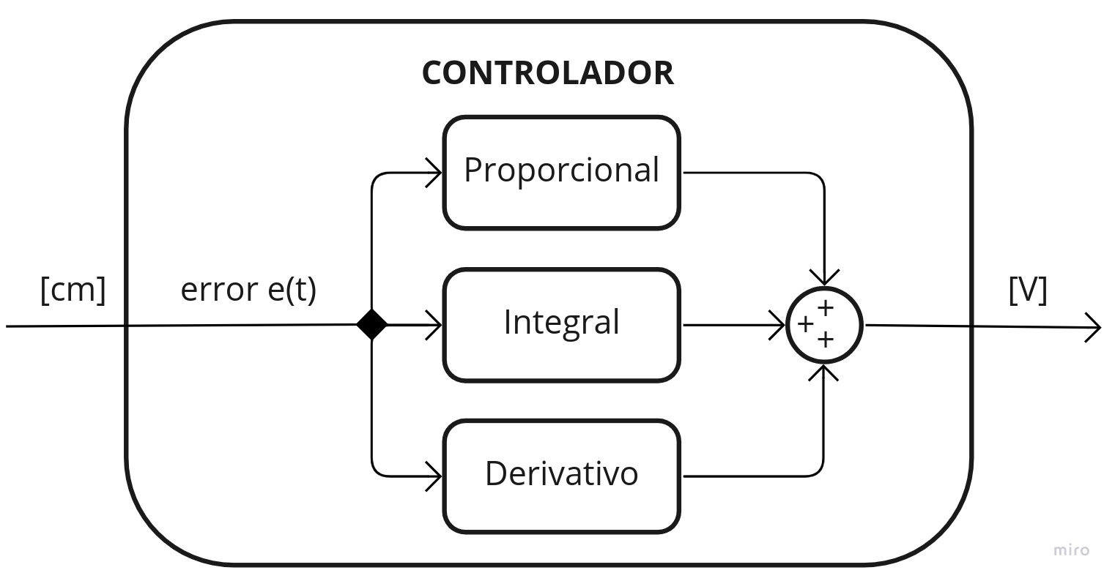
IMAGES/controlador.jpg
