ginos1998/SDC-TP_Final/IMAGES/cooler-pines.jpg

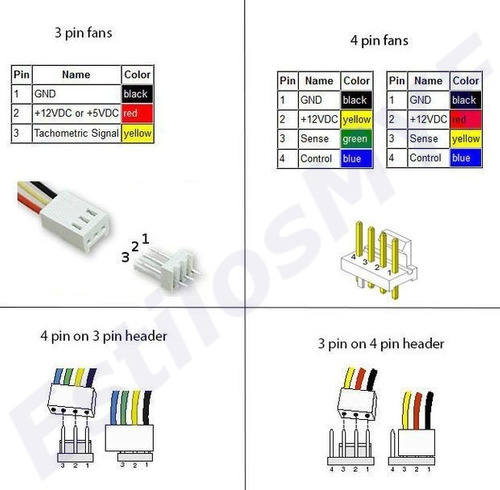
IMAGES/cooler-pines.jpg
