ginos1998/SDC-TP_Final/IMAGES/diagrama-bloques-FdT.jpg

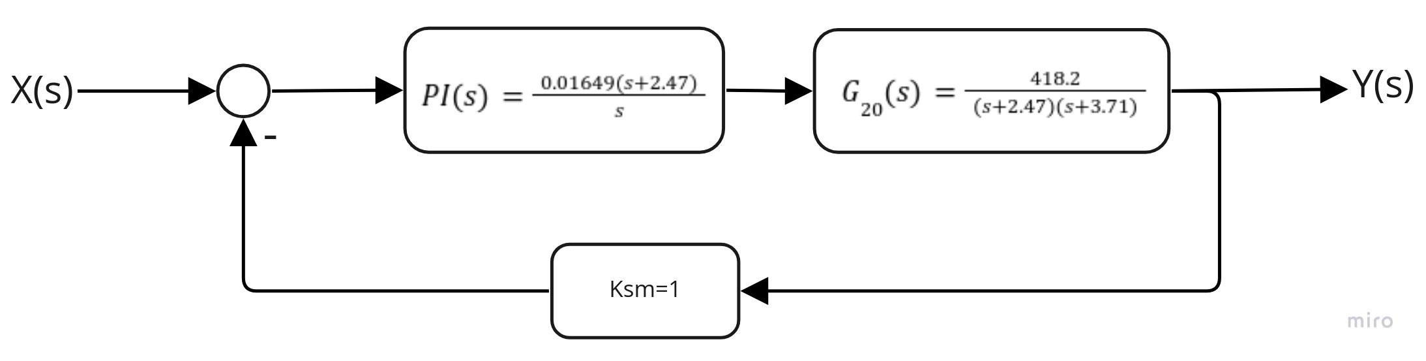
IMAGES/diagrama-bloques-FdT.jpg
