ginos1998/SDC-TP_Final/IMAGES/diagrama-bloques-reducido1.jpg

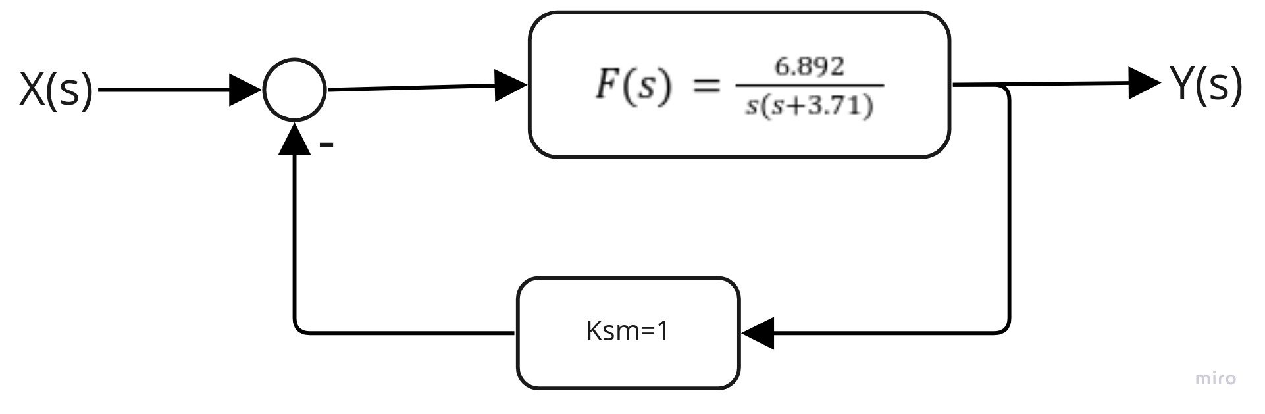
IMAGES/diagrama-bloques-reducido1.jpg
