ginos1998/SDC-TP_Final/IMAGES/diagrama-bloques-reducido2.jpg

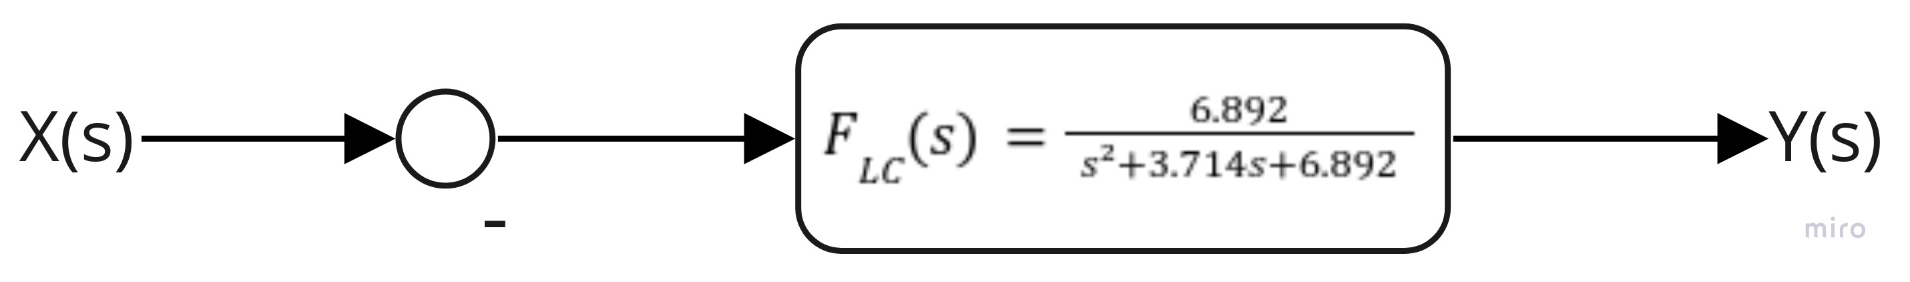
IMAGES/diagrama-bloques-reducido2.jpg
