ginos1998/SDC-TP_Final/IMAGES/diagrama-bloques-sist.jpg

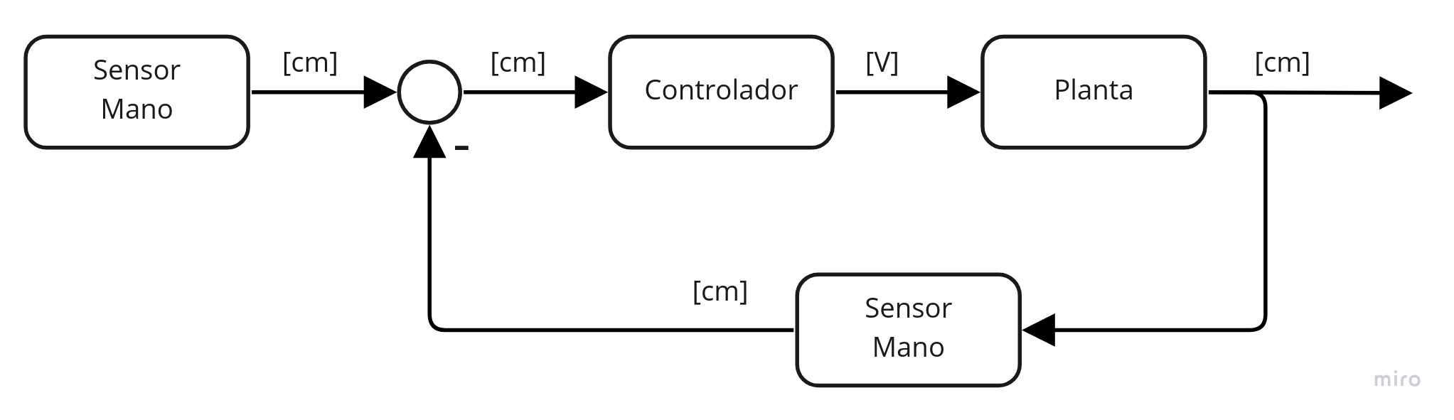
IMAGES/diagrama-bloques-sist.jpg
