ginos1998/SDC-TP_Final/IMAGES/planta.jpg

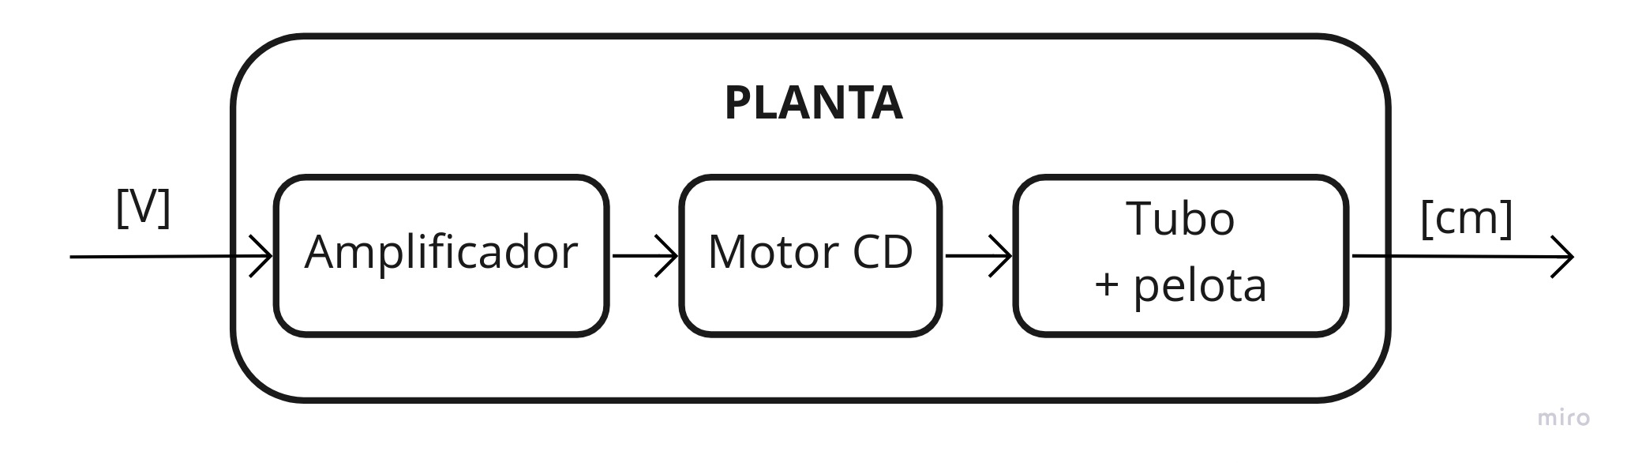
IMAGES/planta.jpg
