ginos1998/SDC-TP_Final/(list of files, drawings)

Other design files:
DISEÑO-CIRCUITO/circuito-proteus.pdsprj
DISEÑO-CIRCUITO/Project Backups/circuito-proteus [20220628, 15-37-53].pdsprj
