ginos1998/SDC-TP_Final/(commit log)

2022-08-02 archivos de arduino
2022-08-02 archivos del proyecto
    [circuito-proteus [20220628, 15-37-53].pdsprj, circuito-proteus.pdsprj, datos_tf_sist_lz.xlsx, estimaciones_tf_motorDC.ods]
2022-08-02 documentacion actualizada: datsheet sensor ultrasonico
